fractalclockwork/soft-xray-pmt/docs/img/README.md

# Board and tube photos

All images are under this directory. Roles for reverse-engineering and portfolio:

## Bring-up harness

Wooden cradle + HV/BNC panel photos live in [`bringup/`](bringup/). Used on the landing [`README.md`](../../README.md).

| File | View |
|---|---|
| [bringup/IMG_8260.jpeg](bringup/IMG_8260.jpeg) | **Hero** — full side profile: tube, filter PCB, divider protoboard, banana HV + BNC |
| [bringup/IMG_8261.jpeg](bringup/IMG_8261.jpeg) | I/O end close-up — BNC, banana jacks, SMA, ERO caps |
| [bringup/IMG_8262.jpeg](bringup/IMG_8262.jpeg) | **Secondary** — photocathode face + wooden cradles |
| [bringup/IMG_8263.jpeg](bringup/IMG_8263.jpeg) | Photocathode face, alternate angle |
| [bringup/IMG_8264.jpeg](bringup/IMG_8264.jpeg) | Side/rear — filter board, SMA, HV panel |

## Part number / overview

| File | View |
|---|---|
| [IMG_6985.JPG](IMG_6985.JPG) | Photonis label — XP3312/SQ SN 294056 |
| [IMG_6998.JPG](IMG_6998.JPG) | Label close-up (same) |
| [IMG_6986.JPG](IMG_6986.JPG) | Base overview (header + coax) on printed datasheet |

## Component / BOM

| File | View |
|---|---|
| [IMG_6989.JPG](IMG_6989.JPG) | Component side, tube attached |
| [IMG_6993.JPG](IMG_6993.JPG) | Component side, leads extended |
| [IMG_7005.JPG](IMG_7005.JPG) | SMD close-up (`100`, `115`, MLCCs) |
| [IMG_7006.JPG](IMG_7006.JPG) | Blue HV cap marking **`472Z` / `2KV`** |
| [IMG_7001.JPG](IMG_7001.JPG) | Header + coax top side |
| [IMG_7002.JPG](IMG_7002.JPG) | Header + coax, clearer |

## Backlight / traces

| File | View |
|---|---|
| [IMG_6992.JPG](IMG_6992.JPG) | Component-side backlight |
| [IMG_7009.JPG](IMG_7009.JPG) | Backlight + C_HV |
| [IMG_7011.JPG](IMG_7011.JPG) | Backlight radial traces |
| [IMG_7014.JPG](IMG_7014.JPG) | Strong backlight — SMD + routing |
| [IMG_7015.JPG](IMG_7015.JPG) | Strong backlight — pad fan-out |
| [IMG_7020.JPG](IMG_7020.JPG) | Header/coax side backlight |

Use [`../photo-bom.md`](../photo-bom.md) and [`../photo-trace-map.md`](../photo-trace-map.md) for extracted connectivity.
