fractalclockwork/soft-xray-pmt/docs/datasheets/XP3312-outline-pins-left.png

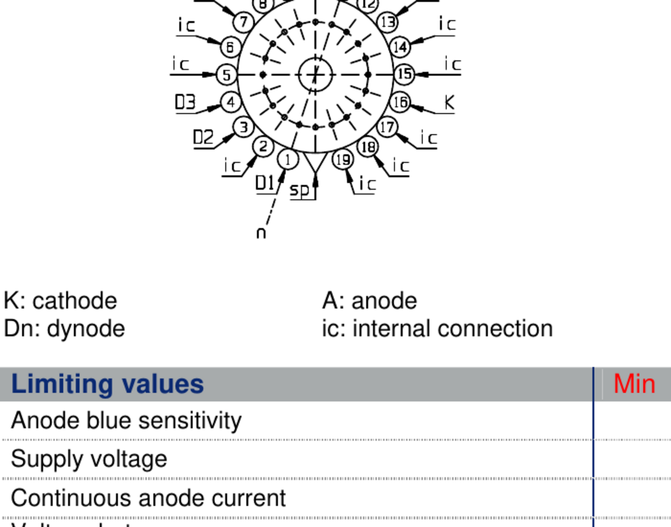
docs/datasheets/XP3312-outline-pins-left.png
