fractalclockwork/soft-xray-pmt/docs/datasheets/XP3312-outline-pins-right.png

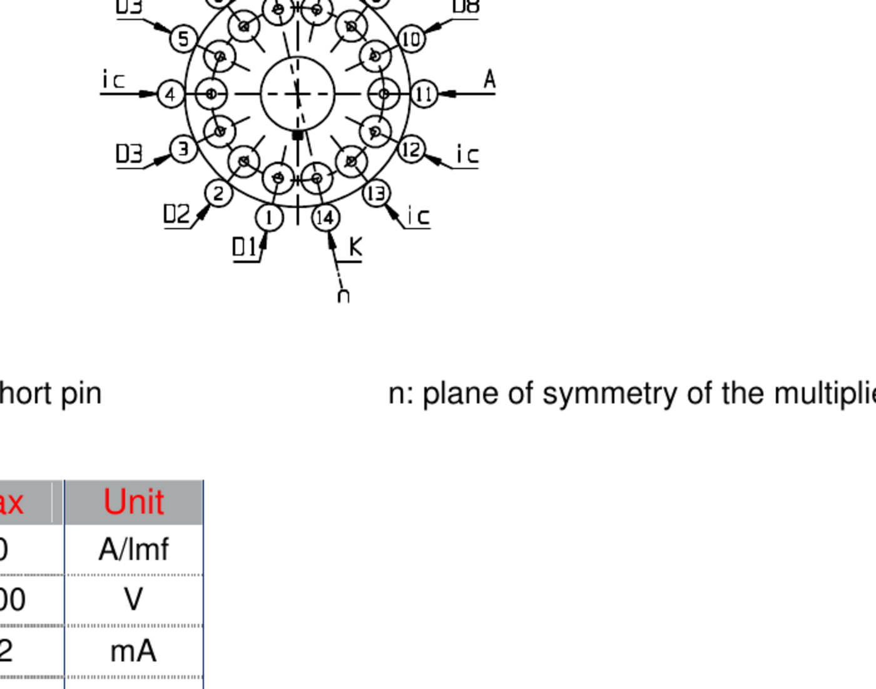
docs/datasheets/XP3312-outline-pins-right.png
