fractalclockwork/soft-xray-pmt/docs/img/IMG_6985.JPG

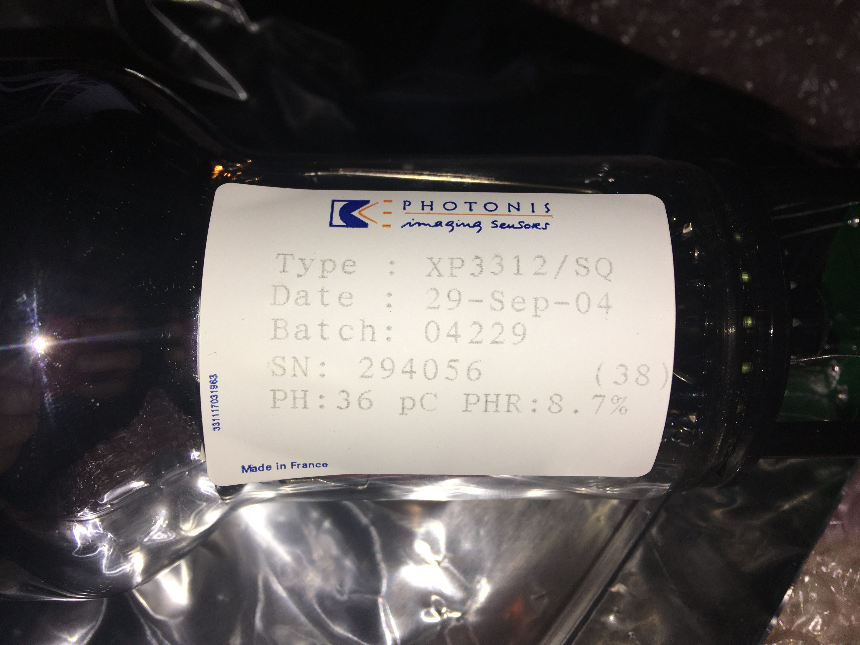
docs/img/IMG_6985.JPG
