fractalclockwork/soft-xray-pmt/docs/img/IMG_6986.JPG

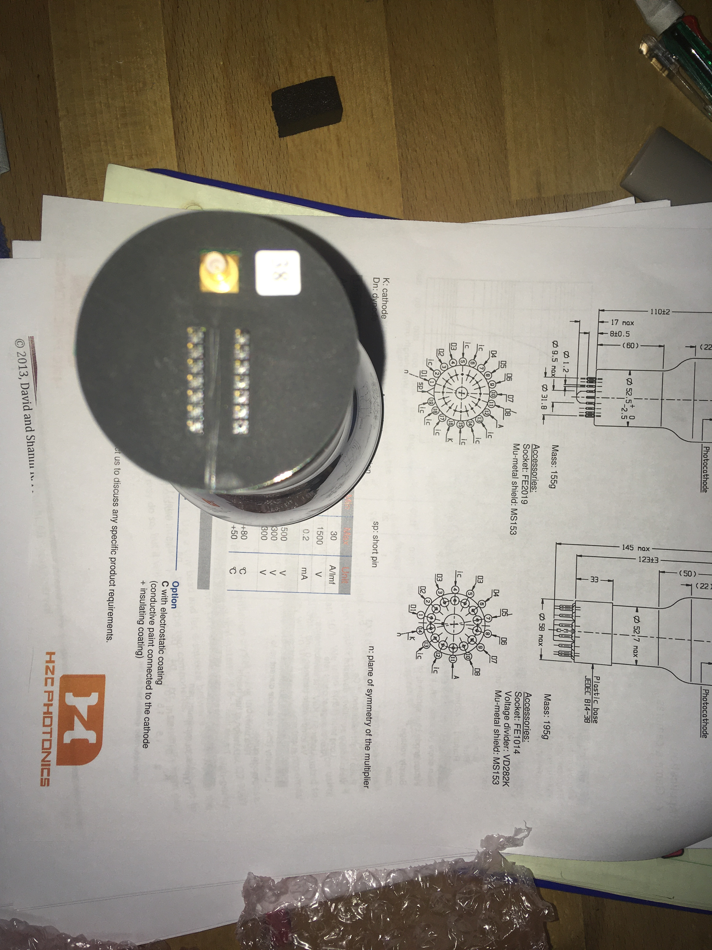
docs/img/IMG_6986.JPG
