fractalclockwork/soft-xray-pmt/docs/img/IMG_6989.JPG

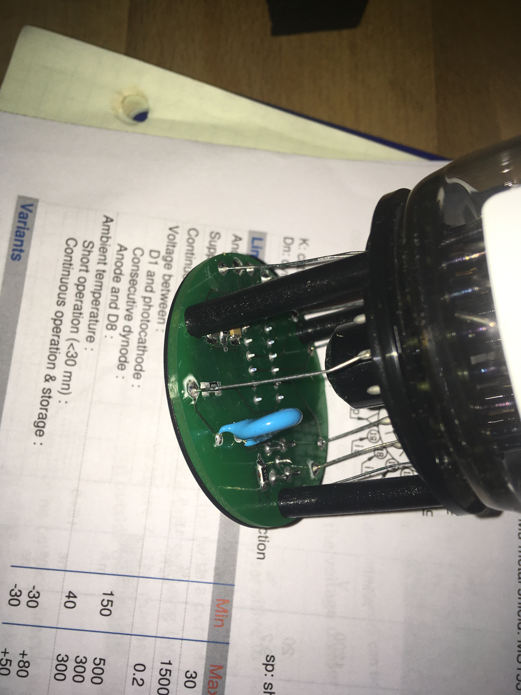
docs/img/IMG_6989.JPG
