fractalclockwork/soft-xray-pmt/docs/img/IMG_6992.JPG

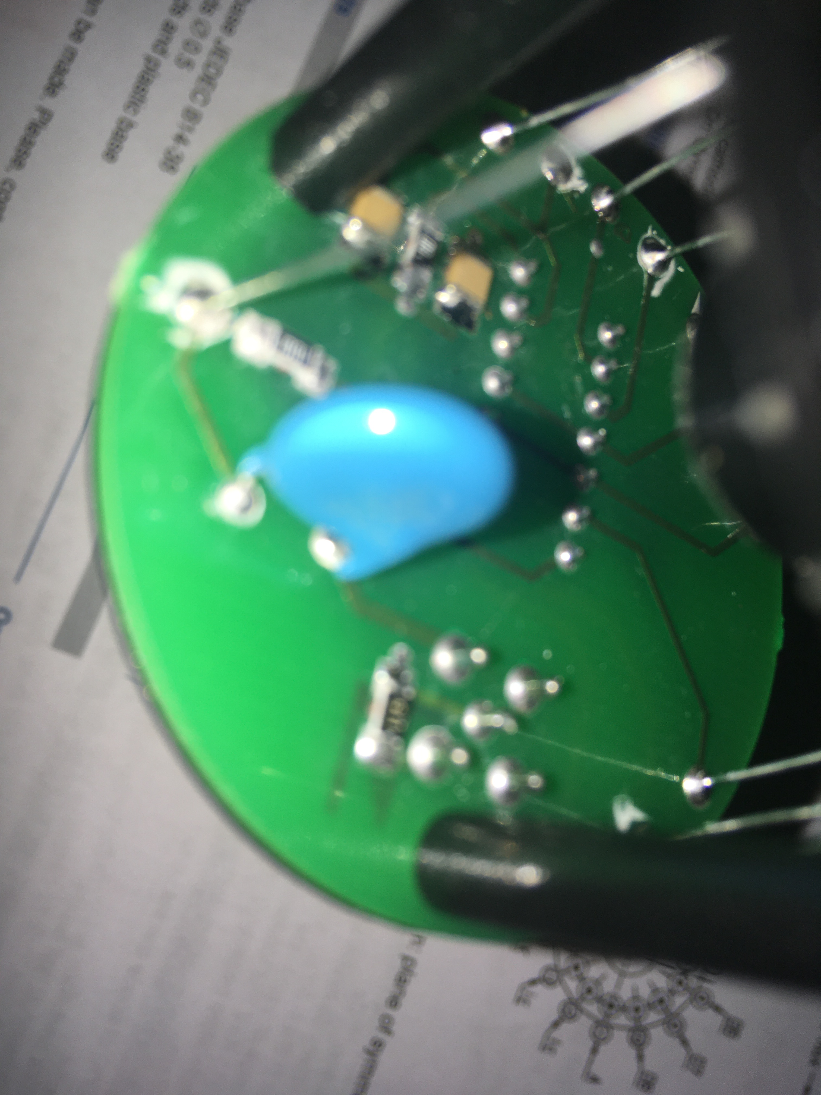
docs/img/IMG_6992.JPG
