fractalclockwork/soft-xray-pmt/docs/img/IMG_6993.JPG

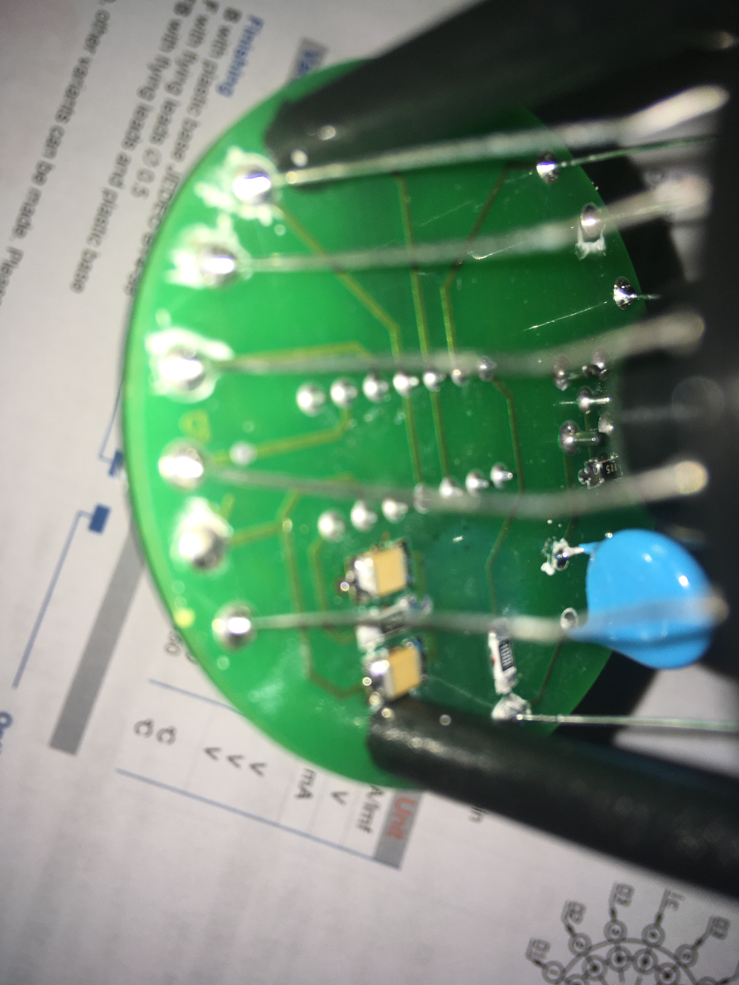
docs/img/IMG_6993.JPG
