fractalclockwork/soft-xray-pmt/docs/img/IMG_6998.JPG

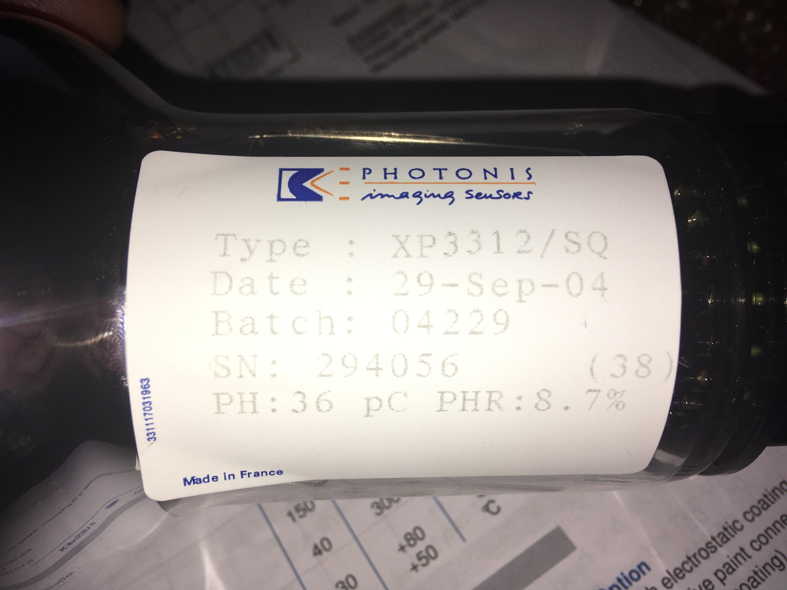
docs/img/IMG_6998.JPG
