fractalclockwork/soft-xray-pmt/docs/img/IMG_7001.JPG

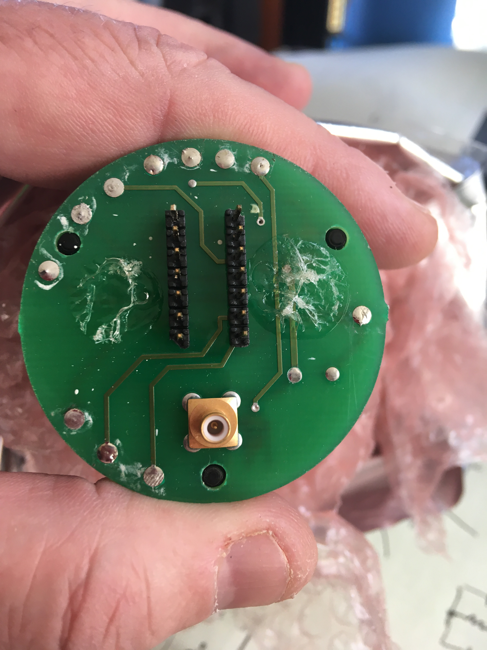
docs/img/IMG_7001.JPG
