fractalclockwork/soft-xray-pmt/docs/img/IMG_7002.JPG

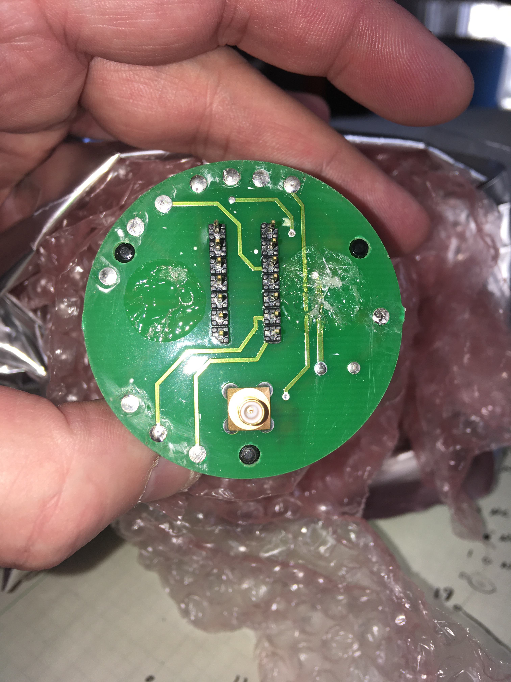
docs/img/IMG_7002.JPG
