fractalclockwork/soft-xray-pmt/docs/img/IMG_7005.JPG

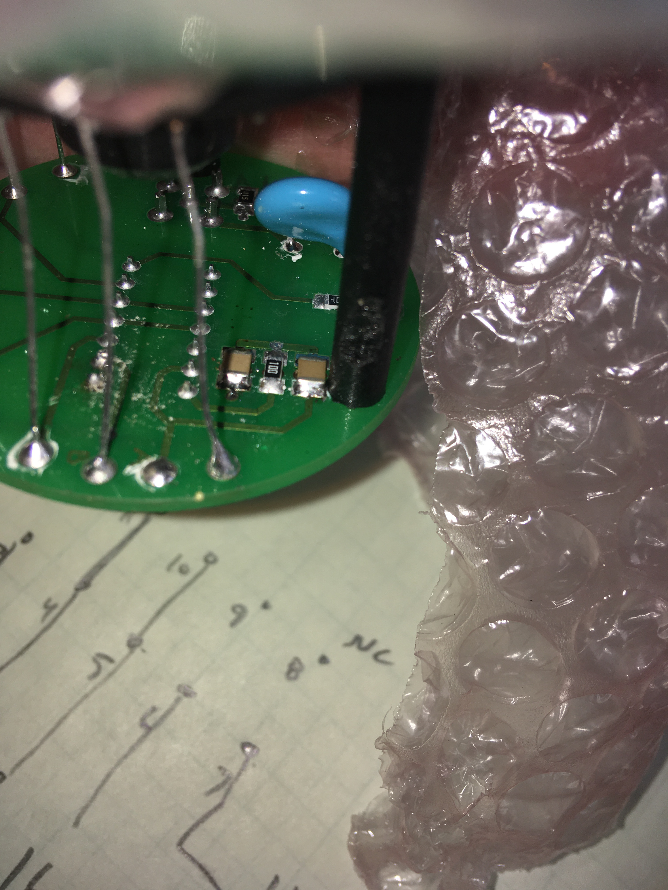
docs/img/IMG_7005.JPG
