fractalclockwork/soft-xray-pmt/docs/img/IMG_7006.JPG

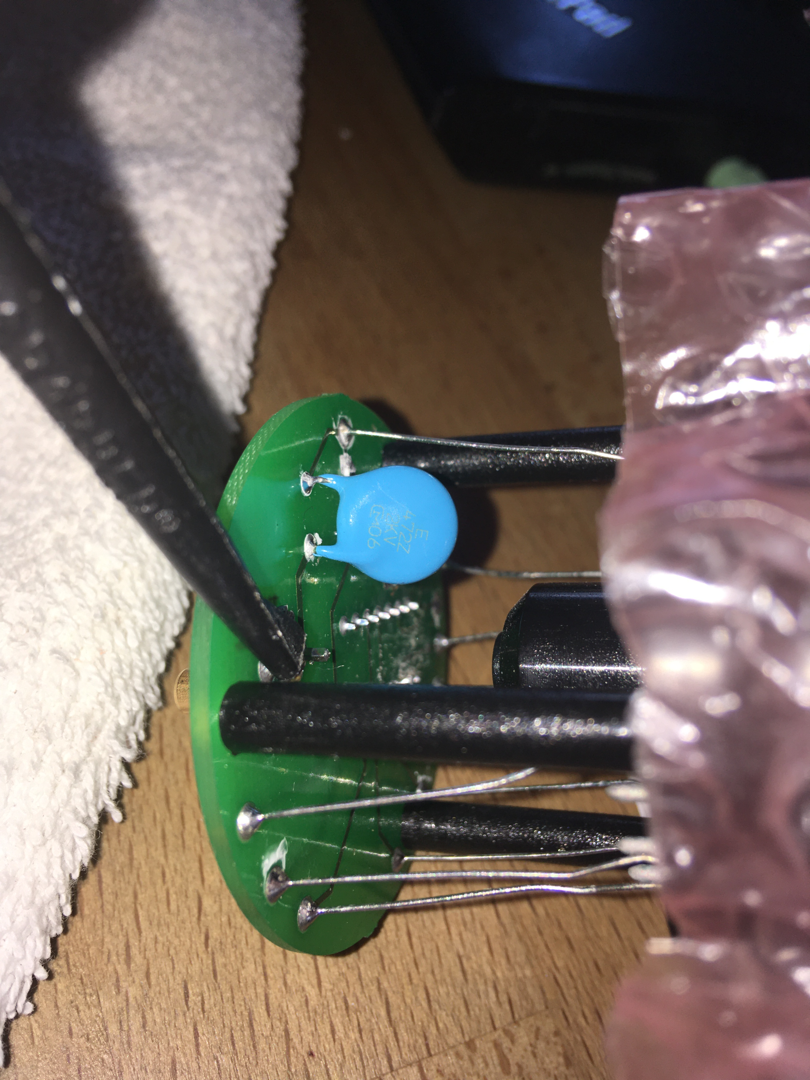
docs/img/IMG_7006.JPG
