fractalclockwork/soft-xray-pmt/docs/img/IMG_7009.JPG

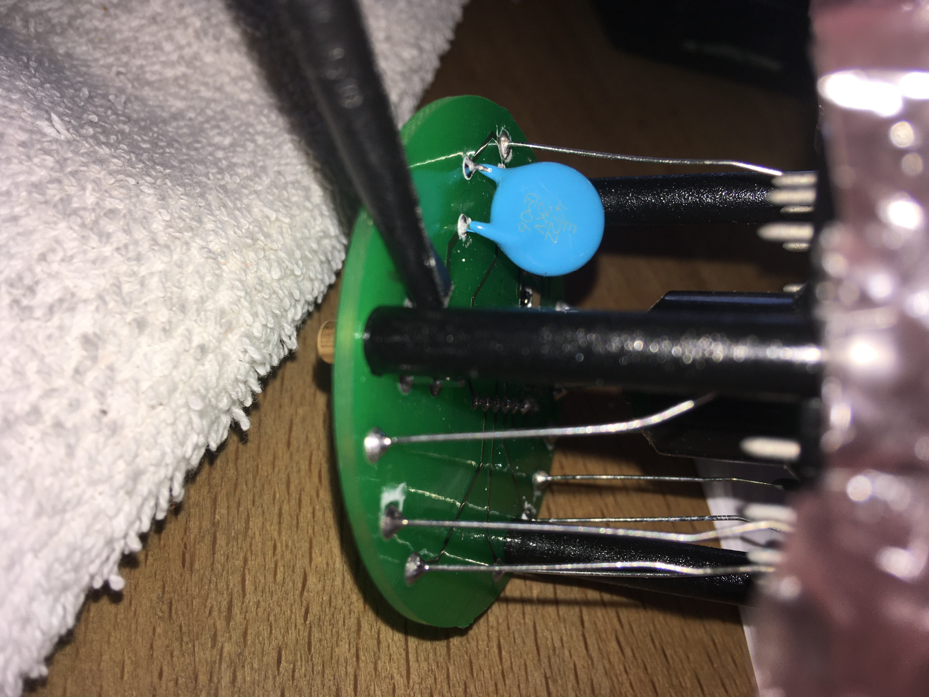
docs/img/IMG_7009.JPG
