fractalclockwork/soft-xray-pmt/docs/img/IMG_7014.JPG

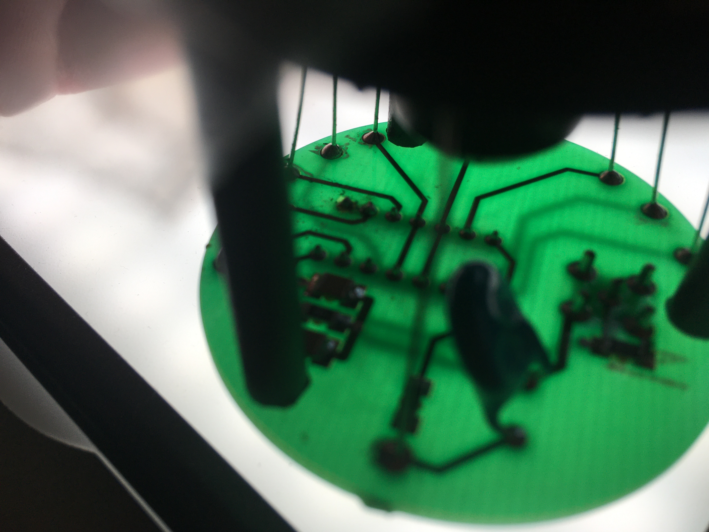
docs/img/IMG_7014.JPG
