fractalclockwork/soft-xray-pmt/docs/img/IMG_7015.JPG

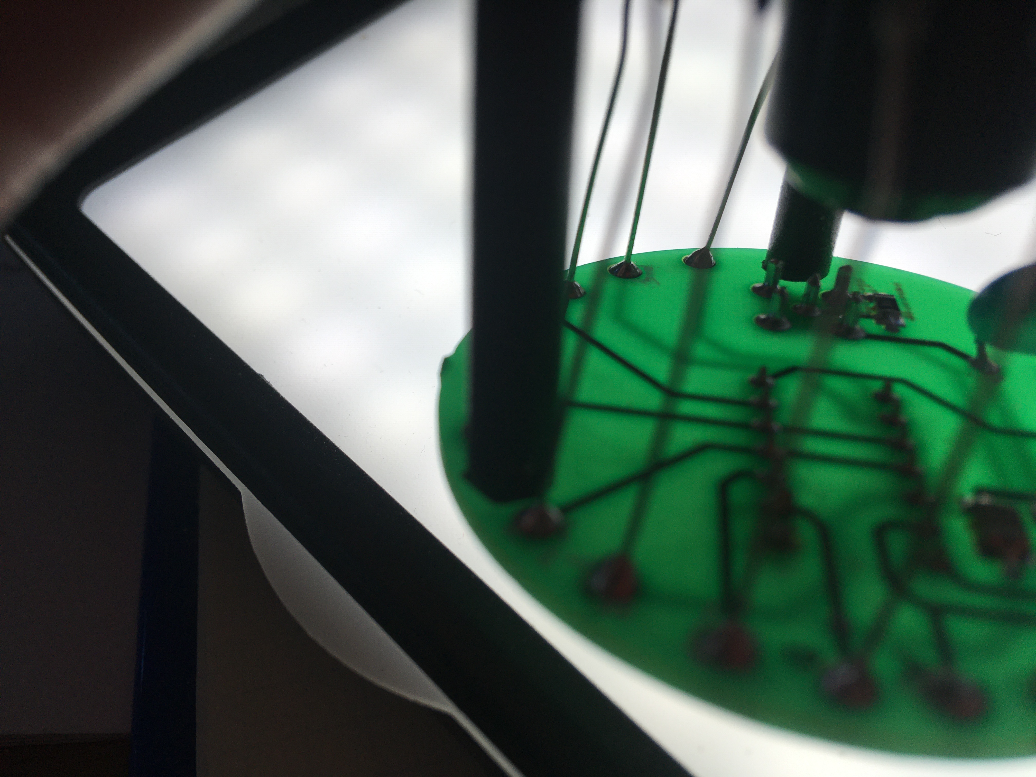
docs/img/IMG_7015.JPG
