fractalclockwork/soft-xray-pmt/docs/img/IMG_7020.JPG

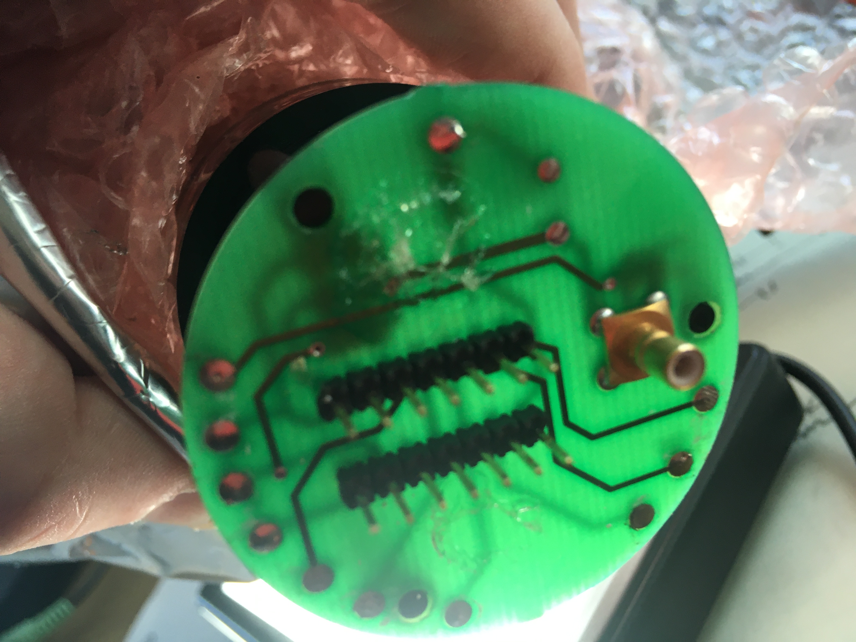
docs/img/IMG_7020.JPG
