fractalclockwork/soft-xray-pmt/docs/img/bringup/IMG_8261.jpeg

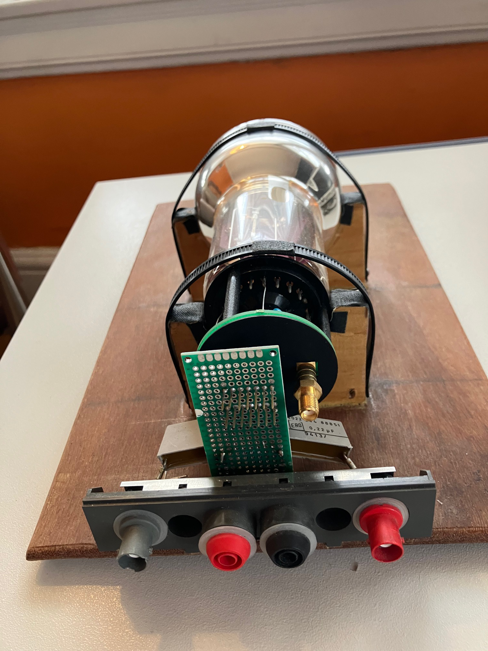
docs/img/bringup/IMG_8261.jpeg
