fractalclockwork/soft-xray-pmt/docs/img/bringup/IMG_8263.jpeg

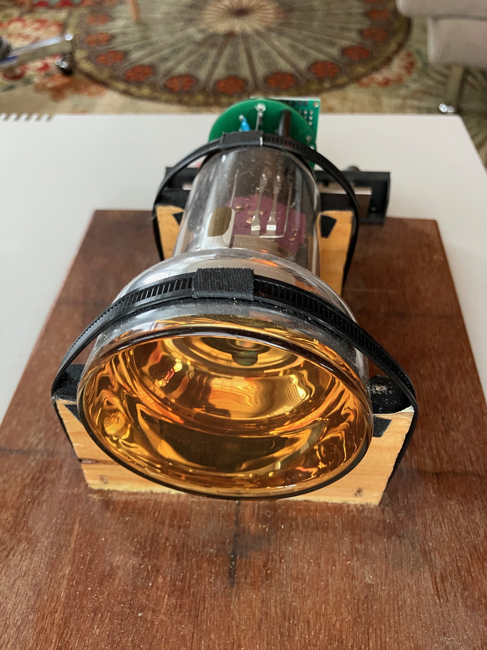
docs/img/bringup/IMG_8263.jpeg
