fractalclockwork/soft-xray-pmt/docs/img/bringup/IMG_8264.jpeg

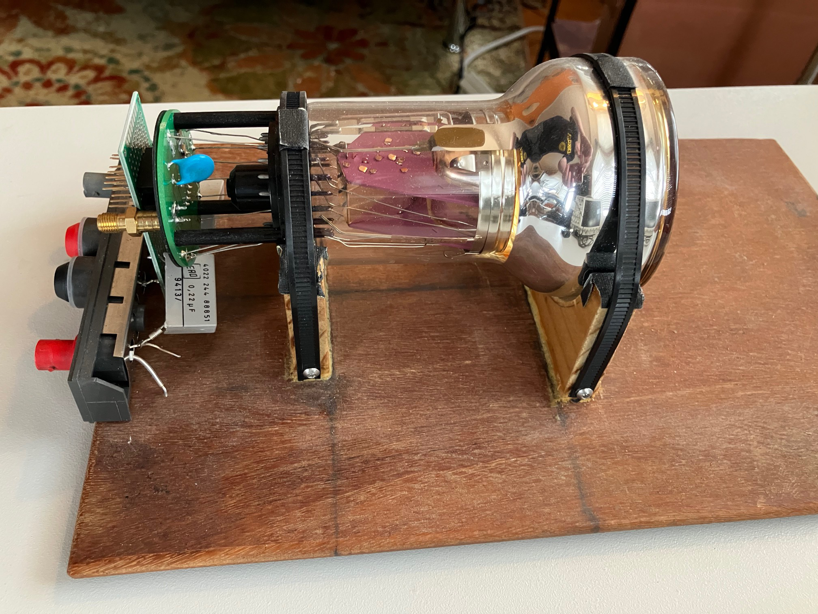
docs/img/bringup/IMG_8264.jpeg
