fractalclockwork/soft-xray-pmt/docs/pmt-interface-draft.pdf

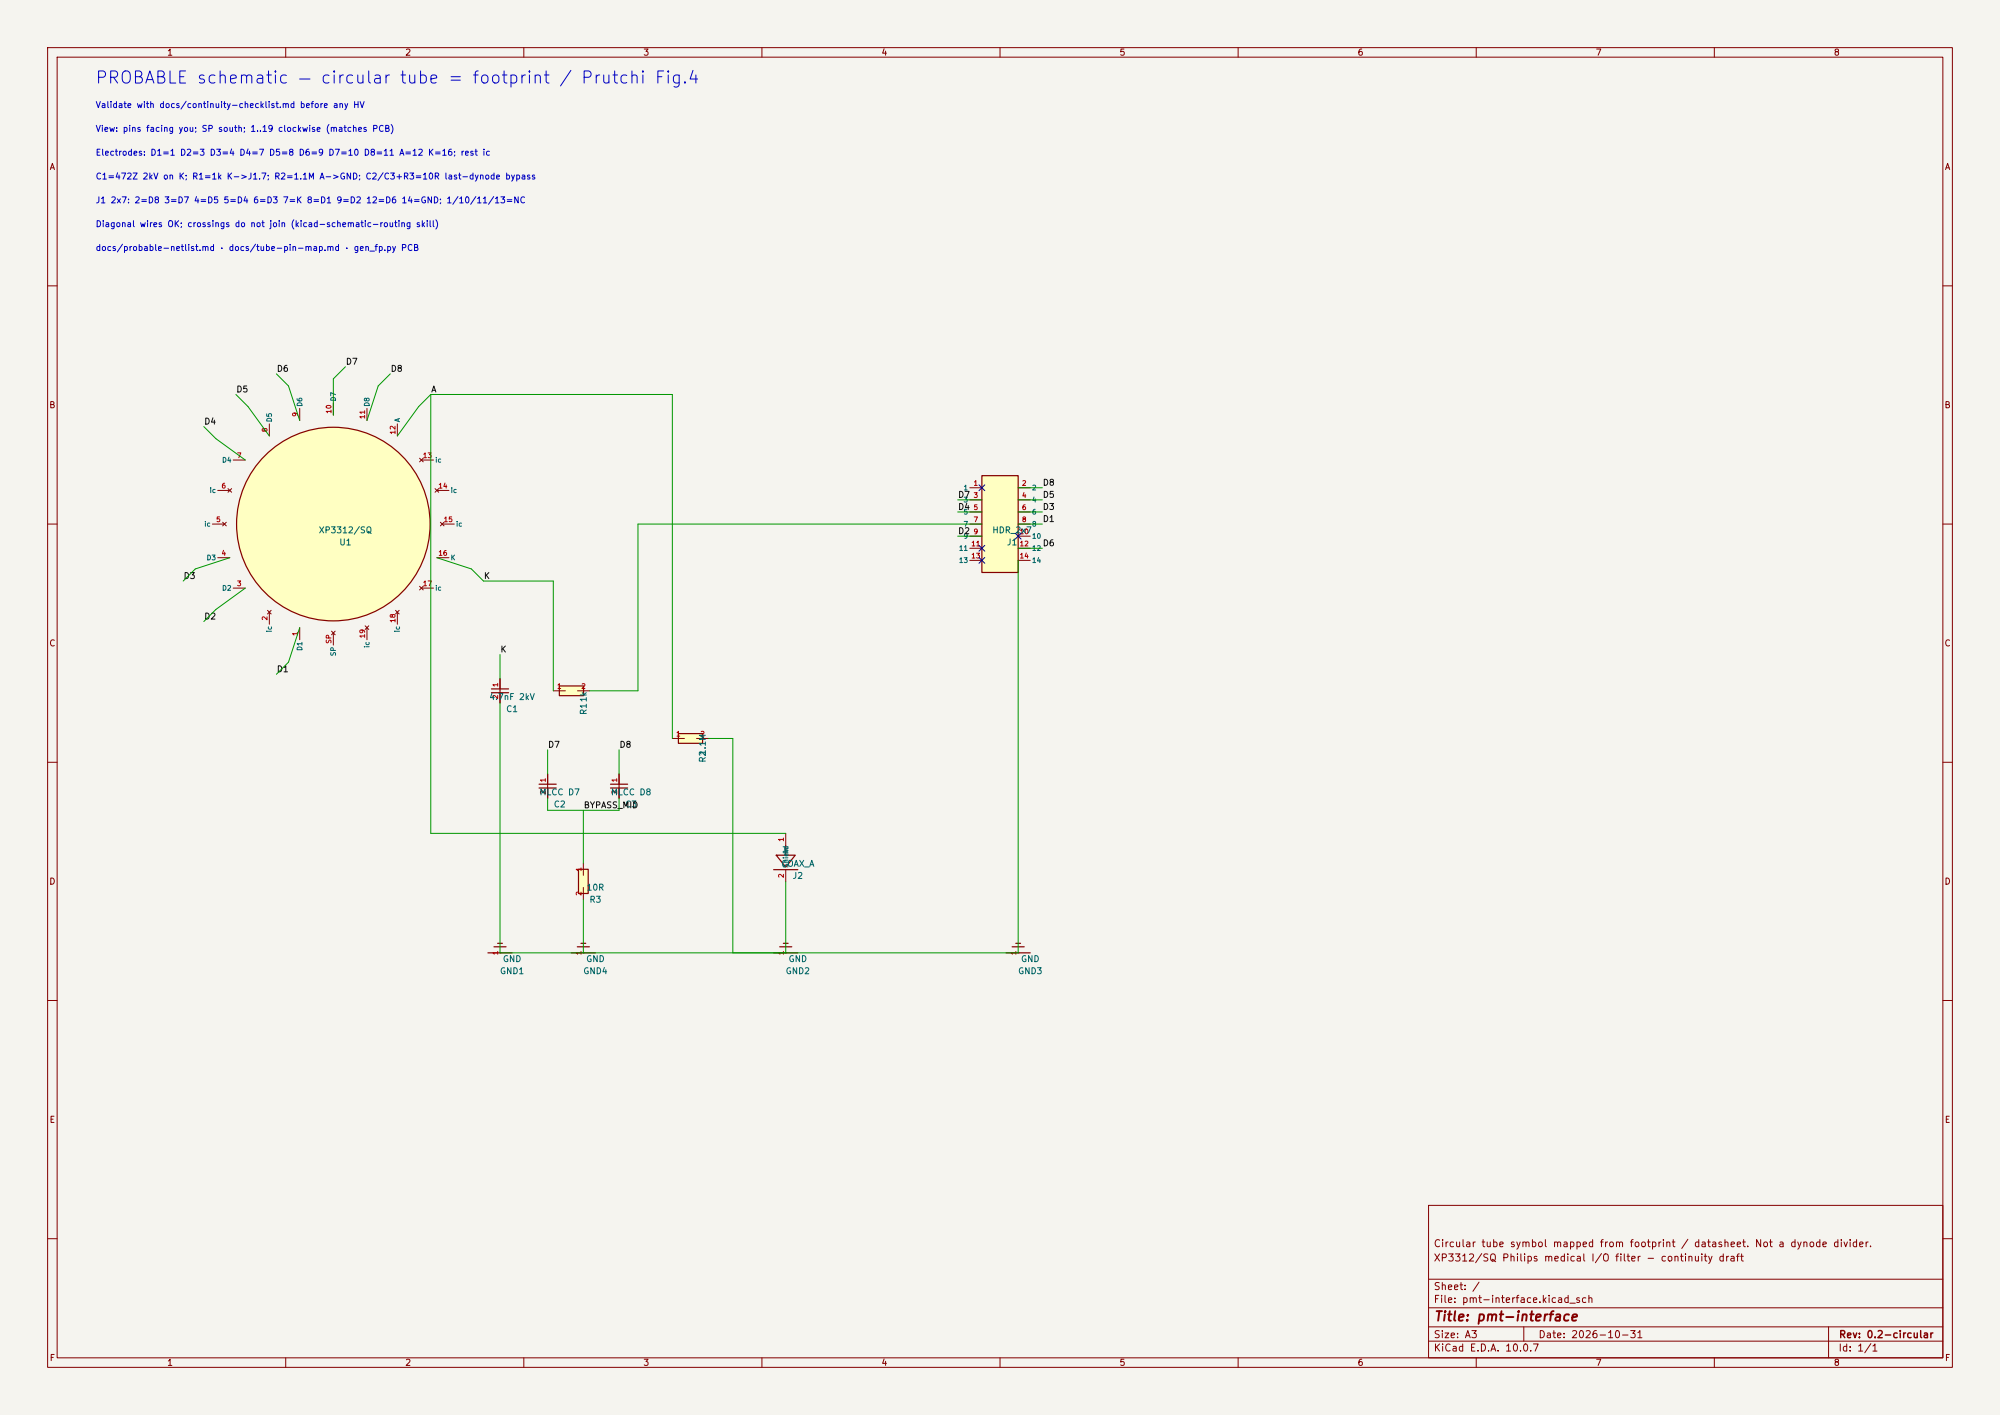
[picture p23: page 1]

View: pins facing you; SP south; 1..19 clockwise (matches PCB) Validate with docs/continuity-checklist.md before any HV PROBABLE schematic — circular tube = footprint / Prutchi Fig.4

Diagonal wires OK; crossings do not join (kicad-schematic-routing skill)

docs/probable-netlist.md · docs/tube-pin-map.md · gen_fp.py PCB

Circular tube symbol mapped from footprint / datasheet. Not a dynode divider.
XP3312/SQ Philips medical I/O filter - continuity draft

Size: A3 | Rev: 0.2-circular | F Date: 2026-10-31
KiCad E.D.A. 10.0.7 | Id: 1/1
