fractalclockwork/soft-xray-pmt/docs/pmt-interface-pcb.pdf

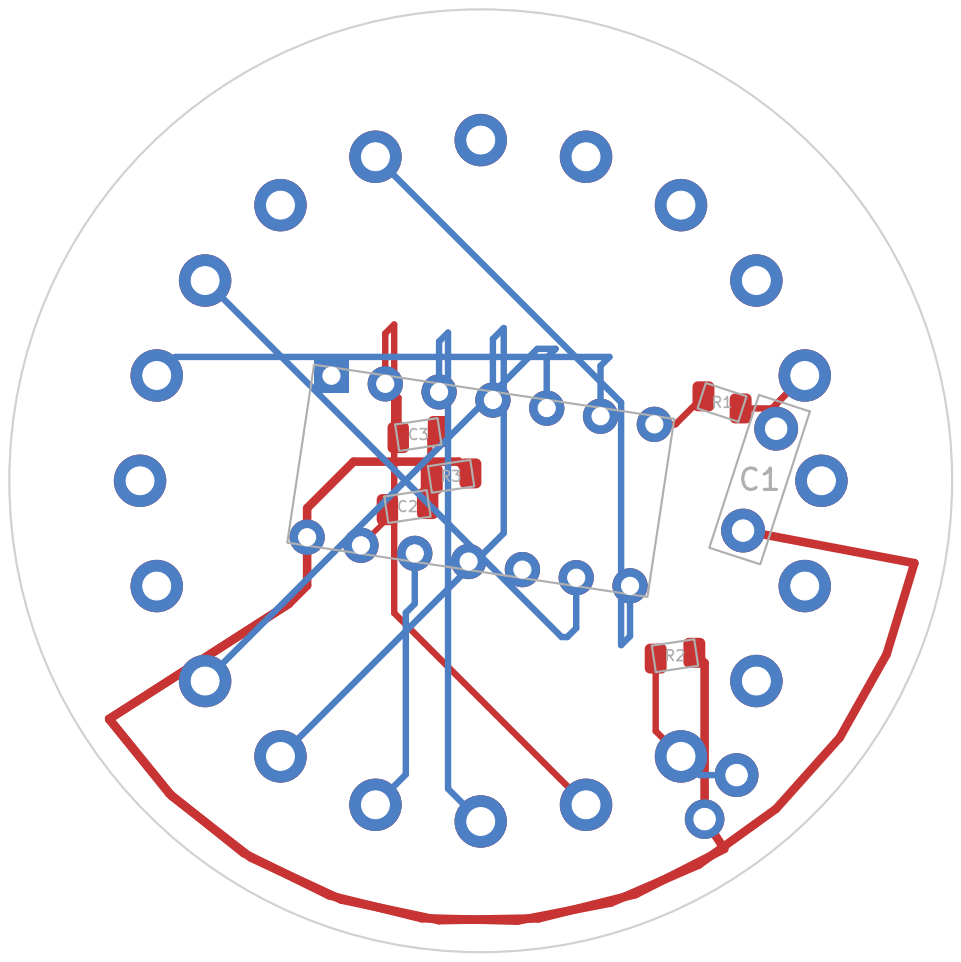
[picture p24: page 1]
