fractalclockwork/soft-xray-pmt/hardware/pmt-interface/bringup-supply.kicad_pcb

## KiCad design hardware/pmt-interface/bringup-supply.kicad_pcb (2026-11-03)

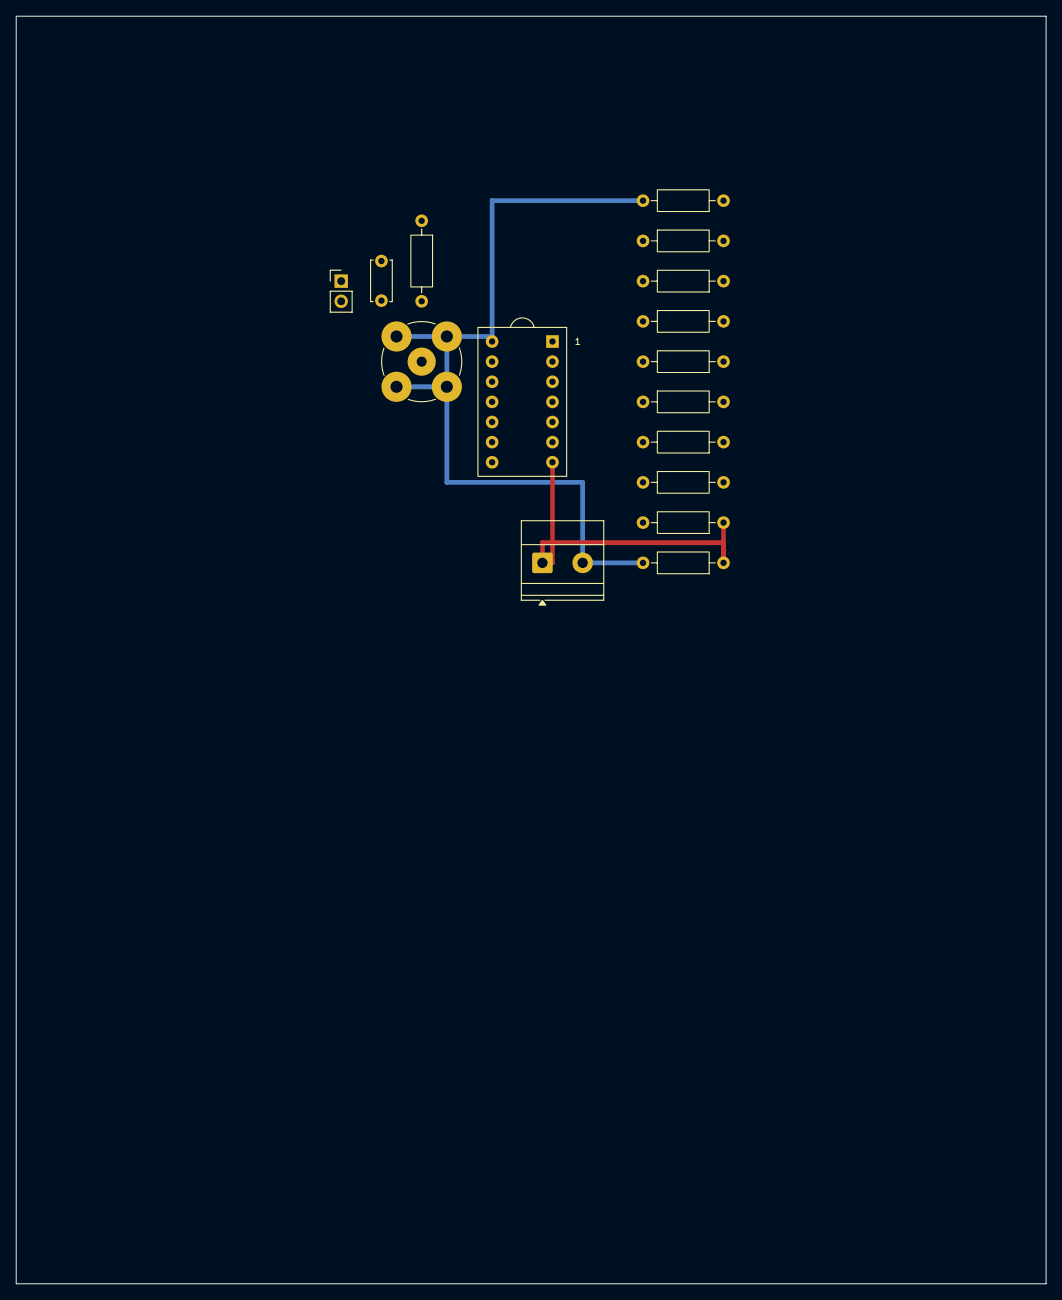
[picture p25: board bringup-supply.kicad_pcb from above]

Board: 10 copper layers, 130.0 x 160.0 mm, 16 parts (0 on the bottom side), 12 nets.

Parts:
C4: 1nF; C_Disc_D5.0mm_W2.5mm_P5.00mm
J3: HV_IN; TerminalBlock_Phoenix_MKDS-1,5-2-5.08_1x02_P5.08mm_Horizont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
J4: MATE_J1; HDR_2x7_IC_Socket
J5: BNC_SCOPE; BNC_TEConnectivity_1478204_Vertical
JMP_DC: DC_COUPLE; PinHeader_1x02_P2.54mm_Vertical
R10: 4.4M; R_Axial_DIN0207_L6.3mm_D2.5mm_P10.16mm_Horizontal
R11, R12, R13: 3.3M; R_Axial_DIN0207_L6.3mm_D2.5mm_P10.16mm_Horizontal
R14, R15, R16, R17: 2.2M; R_Axial_DIN0207_L6.3mm_D2.5mm_P10.16mm_Horizontal
R18: 1.1M; R_Axial_DIN0207_L6.3mm_D2.5mm_P10.16mm_Horizontal
R19: 47R; R_Axial_DIN0207_L6.3mm_D2.5mm_P10.16mm_Horizontal
Rbleed: 22M; R_Axial_DIN0207_L6.3mm_D2.5mm_P10.16mm_Horizontal

Connections:
A: C4.1, JMP_DC.1, R19.1
D1: J4.8, R10.2, R11.1
D2: J4.9, R11.2, R12.1
D3: J4.6, R12.2, R13.1
D4: J4.5, R13.2, R14.1
D5: J4.4, R14.2, R15.1
D6: J4.12, R15.2, R16.1
D7: J4.3, R16.2, R17.1
D8: J4.2, R17.2, R18.1
GND: J3.2, J4.14, J5.2, R18.2, Rbleed.2
K: J3.1, J4.7, R10.1, Rbleed.1
SCOPE: C4.2, J5.1, JMP_DC.2, R19.2
