fractalclockwork/soft-xray-pmt/hardware/pmt-interface/pmt-interface.kicad_pcb

## KiCad design hardware/pmt-interface/pmt-interface.kicad_pcb (2026-11-02)

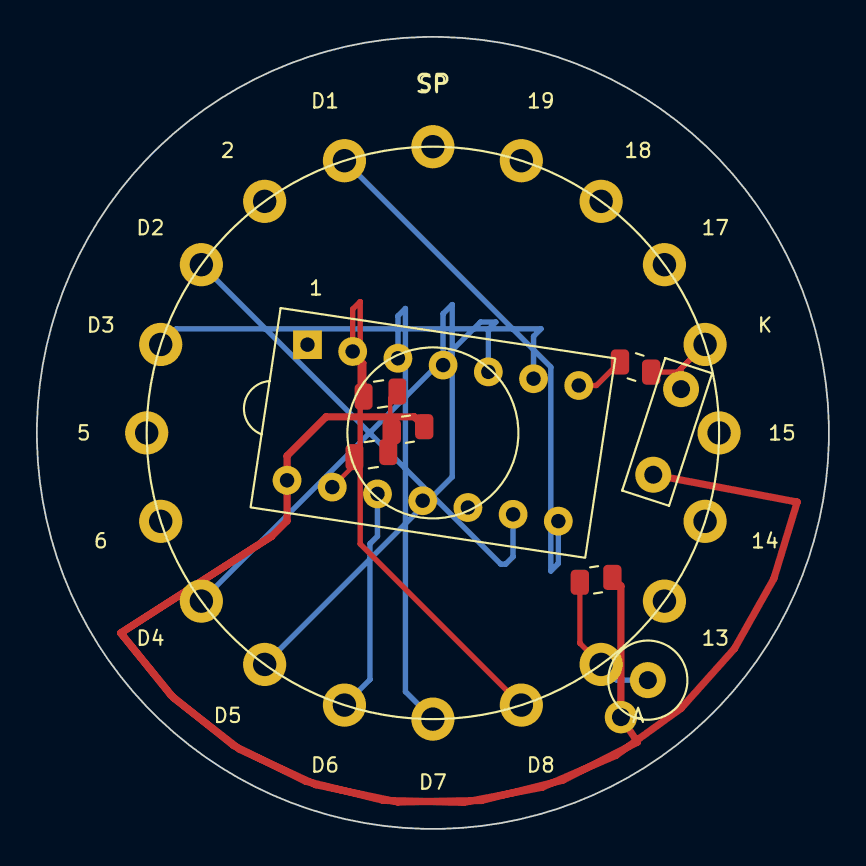
[picture p26: board pmt-interface.kicad_pcb from above]

Board: 2 copper layers, 44.0 x 44.0 mm, 9 parts (1 on the bottom side), 14 nets.

Parts:
C1: 4.7nF 2kV; C_Disc_D7.5mm_W2.5mm_P5.00mm
C2: MLCC J1.13; C_0805_2012Metric
C3: MLCC D8; C_0805_2012Metric
J1: HDR_2x7_IC_Socket
J2: COAX; COAX_Edge
R1: 1k; R_0805_2012Metric
R2: 1.1M; R_0805_2012Metric
R3: 10R; R_0805_2012Metric
U1: XP3312/SQ; XP3312_FlyingLead

Connections:
A: J2.1, R2.1, U1.12
BYPASS_MID: C2.2, C3.2, R3.1
D1: J1.8, U1.1
D2: J1.9, U1.3
D3: J1.6, U1.4
D4: J1.5, U1.7
D5: J1.4, U1.8
D6: J1.12, U1.9
D7: J1.3, U1.10
D8: C3.1, J1.2, U1.11
GND: C1.2, J1.14, J2.2, R2.2, R3.2
J1.13: C2.1, J1.13
K: C1.1, R1.1, U1.16
R1_J1: J1.7, R1.2
