fractalclockwork/soft-xray-pmt/(commit log)

2026-11-03 power pcb verified and sch/pcb skill created
    [bringup-supply.kicad_pcb, bringup-supply.kicad_sch]
2026-11-03 finalized power pcb and skill
