fractalclockwork/soft-xray-pmt/docs/img/IMG_7011.JPG

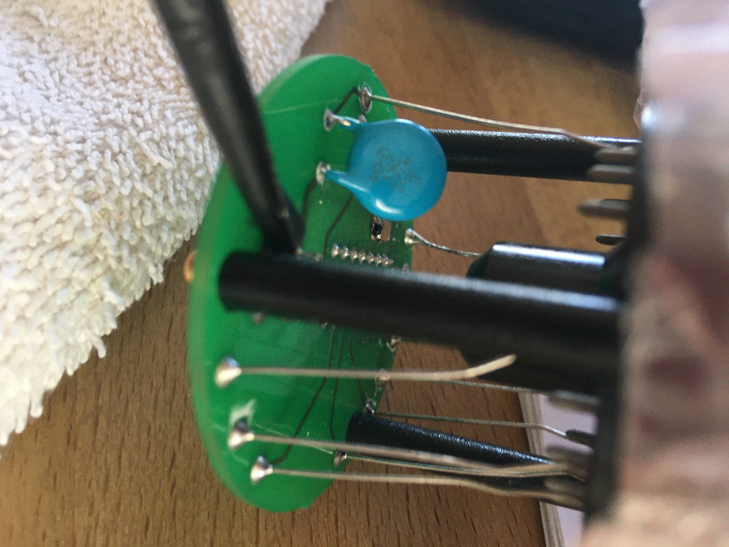
docs/img/IMG_7011.JPG
